jeihcio/Montadora_Carro_Ia/(commit log)

2026-09-17 Atualiza documentação visual do fluxo
    Atualiza o README para substituir o diagrama textual do ciclo da esteira por uma imagem do fluxo de funcionamento e inclui a nova ilustração do sistema. Também revisa a imagem da maquete física para refletir melhor a estrutura do projeto e facilitar a compreensão do comportamento da inspeção com IA.
2026-09-17 Organizar assets e atualizar README
    Move as imagens do projeto para a pasta Asserts/Imagens e ajusta todos os links no README para apontar para os novos caminhos. Também adiciona a imagem do esquema elétrico e repete a foto da maquete na seção de montagem para melhorar a documentação visual do projeto.
2026-09-18 Atualiza diagrama elétrico da maquete
    A documentação foi atualizada para usar o novo esquema elétrico técnico da maquete. O README agora referencia a imagem correta e os assets de imagem foram revisados para refletir a versão final do sistema.
